edgecollective/mesh-depth/remote/v0.2/hardware/mesh-depth/mesh-depth.pdf

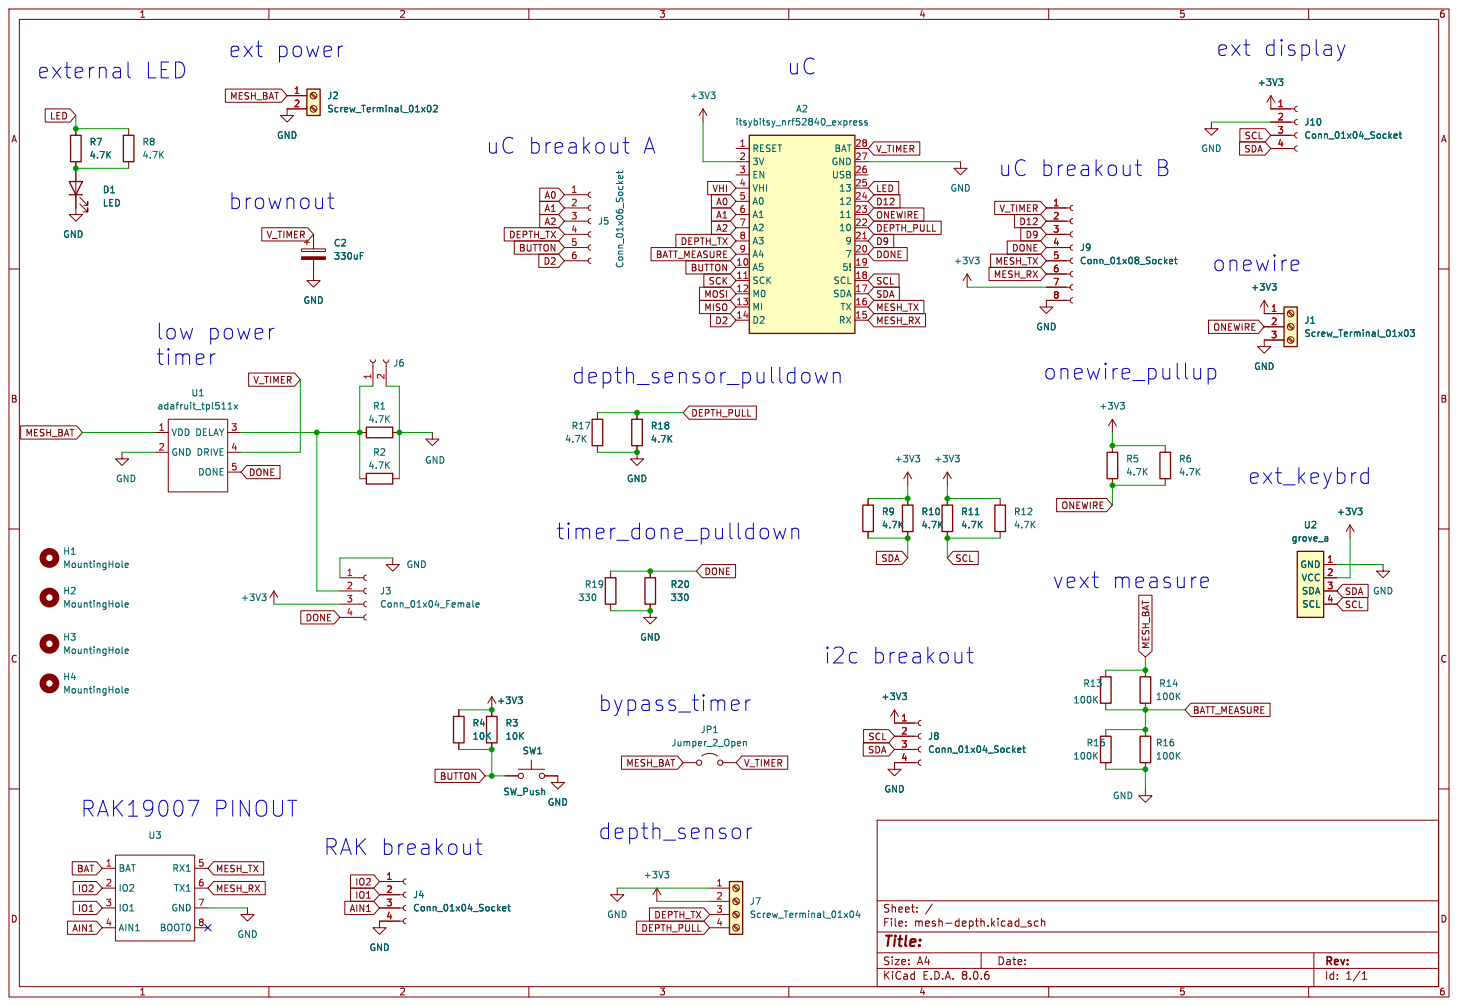
[picture p1: page 1]
