edgecollective/mesh-depth/remote/v0.2/hardware/mesh-depth/mesh-depth.kicad_pcb

## KiCad design remote/v0.2/hardware/mesh-depth/mesh-depth.kicad_pcb (2025-04-04)

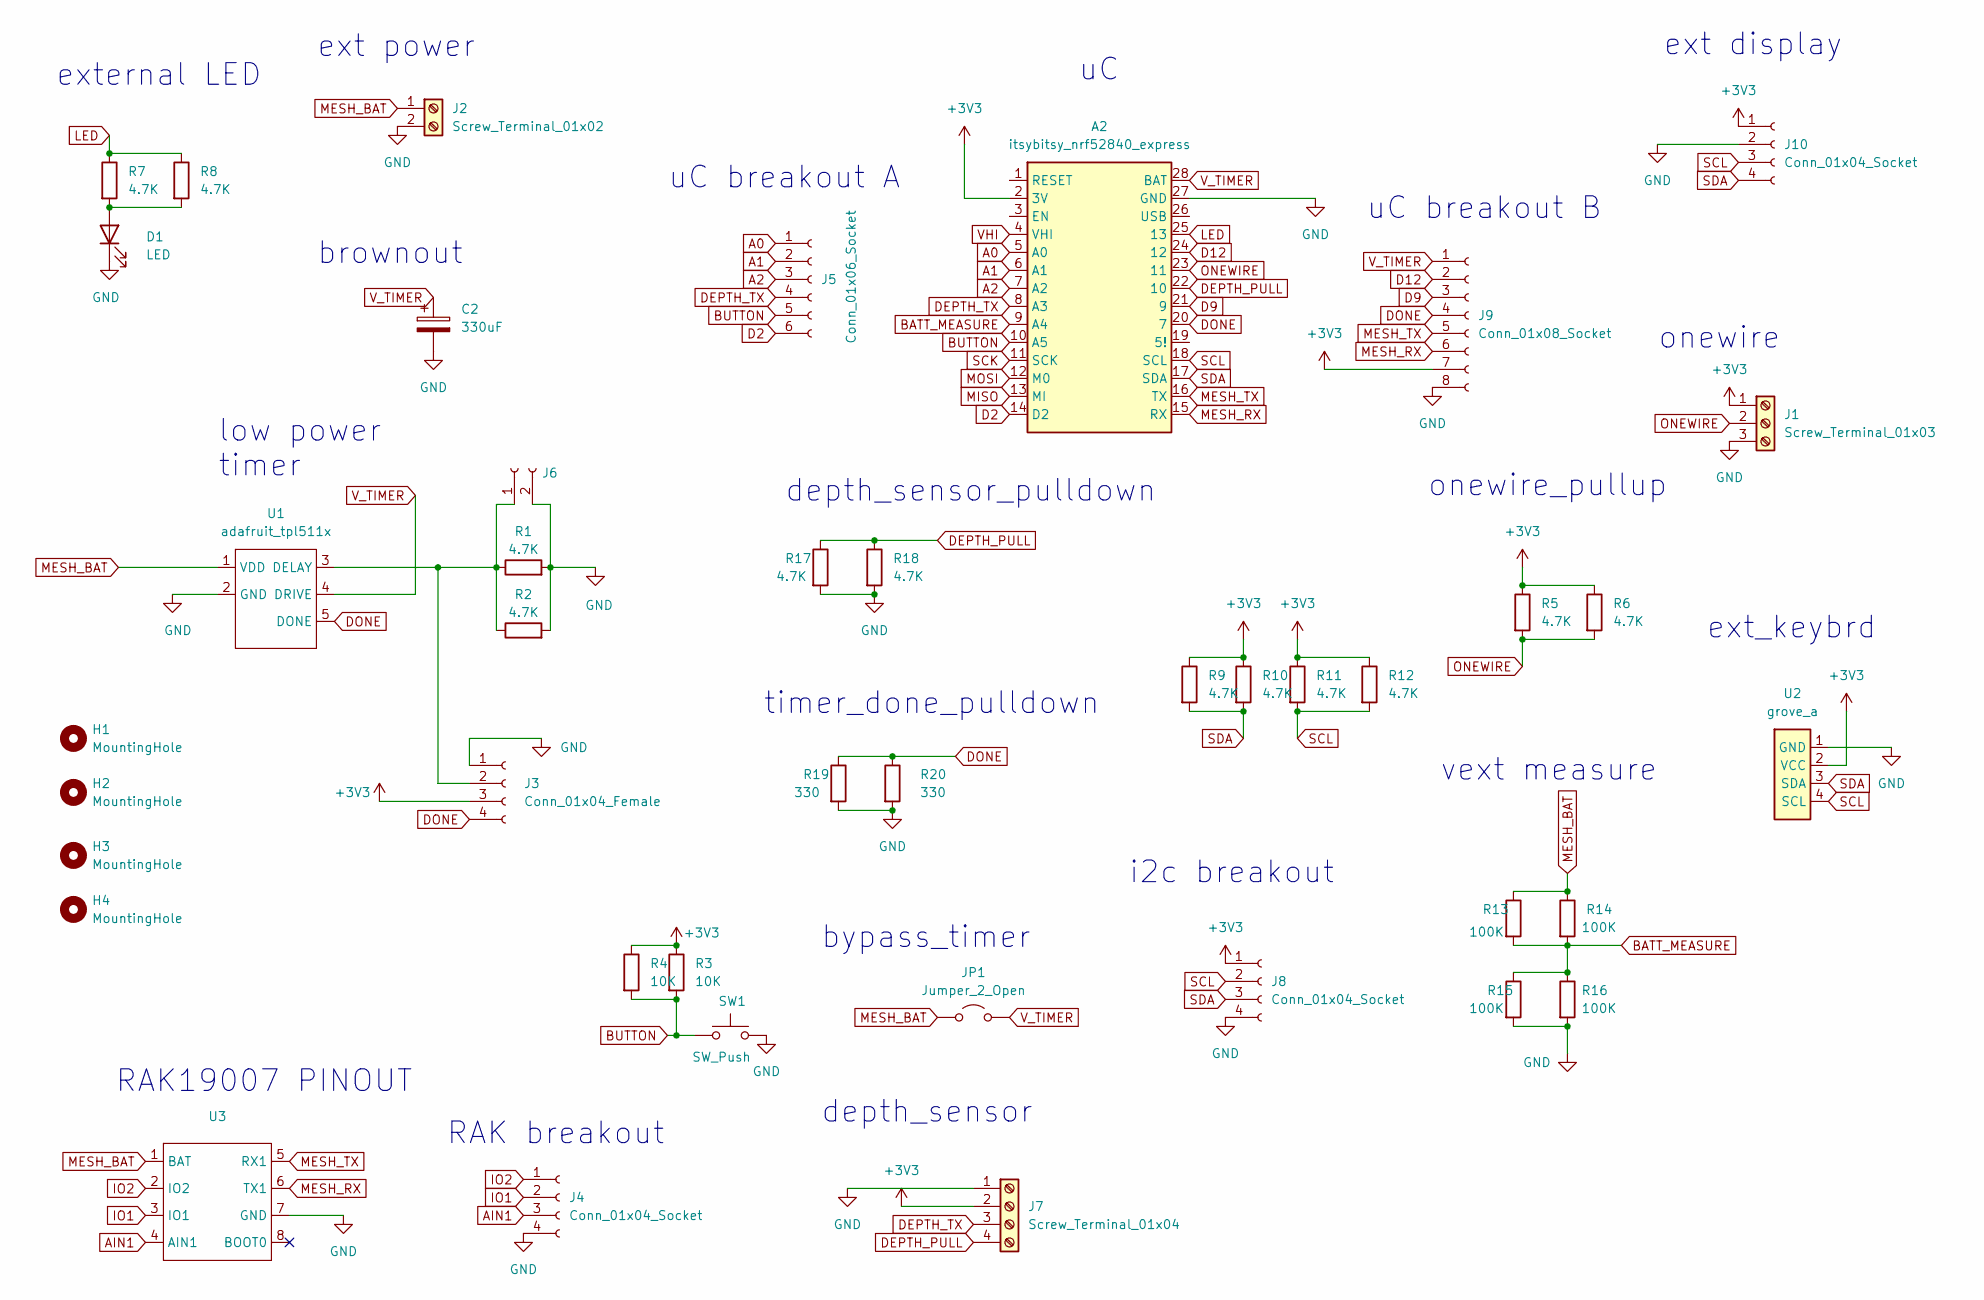
[picture p2: schematic mesh-depth.kicad_sch]

Parts:
A2: itsybitsy_nrf52840_express; itsybitsy
C2: 330uF; CP_Radial_D5.0mm_P2.00mm
D1: LED; LED_D5.0mm
H1, H2, H3, H4: MountingHole; MountingHole_3.2mm_M3
J1: Screw_Terminal_01x03; TerminalBlock_Phoenix_MKDS-1,5-3_1x03_P5.00mm_Horizontal
J2: Screw_Terminal_01x02; TerminalBlock_Phoenix_MKDS-1,5-2_1x02_P5.00mm_Horizontal
J3: Conn_01x04_Female; PinSocket_1x04_P2.54mm_Vertical
J4, J8: Conn_01x04_Socket; PinHeader_1x04_P2.54mm_Vertical
J5: Conn_01x06_Socket; PinHeader_1x06_P2.54mm_Vertical
J6: Conn_01x02_Socket; PinSocket_1x02_P2.54mm_Vertical
J7: Screw_Terminal_01x04; TerminalBlock_Phoenix_MKDS-1,5-4_1x04_P5.00mm_Horizontal
J9: Conn_01x08_Socket; PinHeader_1x08_P2.54mm_Vertical
J10: Conn_01x04_Socket; ssd1306_a
JP1: Jumper_2_Open; SolderJumper-2_P1.3mm_Open_Pad1.0x1.5mm
R1, R5, R8, R10, R11, R18: 4.7K; R_0603_1608Metric_Pad0.98x0.95mm_HandSolder
R2, R6, R7, R9, R12, R17: 4.7K; R_Axial_DIN0204_L3.6mm_D1.6mm_P7.62mm_Horizontal
R3: 10K; R_0603_1608Metric_Pad0.98x0.95mm_HandSolder
R4: 10K; R_Axial_DIN0204_L3.6mm_D1.6mm_P7.62mm_Horizontal
R13, R15: 100K; R_Axial_DIN0204_L3.6mm_D1.6mm_P7.62mm_Horizontal
R14, R16: 100K; R_0603_1608Metric_Pad0.98x0.95mm_HandSolder
R19: 330; R_Axial_DIN0204_L3.6mm_D1.6mm_P7.62mm_Horizontal
R20: 330; R_0603_1608Metric_Pad0.98x0.95mm_HandSolder
SW1: SW_Push; SW_PUSH_6mm
U1: adafruit_tpl511x
U2: grove_a
U3: rak19007

Connections:
+3V3: A2.2 (3V), J1.1, J3.3, J7.2, J8.1, J9.7, J10.1, R3.1, R4.1, R5.1, R6.1, R9.1, R10.1, R11.1, R12.1, U2.2 (VCC)
A0: A2.5 (A0), J5.1
A1: A2.6 (A1), J5.2
A2: A2.7 (A2), J5.3
AIN1: J4.3, U3.4 (AIN1)
BATT_MEASURE: A2.9 (A4), R13.2, R14.2, R15.1, R16.1
BUTTON: A2.10 (A5), J5.5, R3.2, R4.2, SW1.1
D2: A2.14 (D2), J5.6
D9: A2.21 (9), J9.3
D12: A2.24 (12), J9.2
DEPTH_PULL: A2.22 (10), J7.4, R17.1, R18.1
DEPTH_TX: A2.8 (A3), J5.4, J7.3
DONE: A2.20 (7), J3.4, J9.4, R19.1, R20.1, U1.5 (DONE)
GND: A2.27 (GND), C2.2, D1.1 (K), J1.3, J2.2, J3.1, J4.4, J6.2, J7.1, J8.4, J9.8, J10.2, R1.2, R2.2, R15.2, R16.2, R17.2, R18.2, R19.2, R20.2, SW1.2, U1.2 (GND), U2.1 (GND), U3.7 (GND)
IO1: J4.2, U3.3 (IO1)
IO2: J4.1, U3.2 (IO2)
LED: A2.25 (13), R7.1, R8.1
MESH_BAT: J2.1, JP1.1 (A), R13.1, R14.1, U1.1 (VDD), U3.1 (BAT)
MESH_RX: A2.15 (RX), J9.6, U3.6 (TX1)
MESH_TX: A2.16 (TX), J9.5, U3.5 (RX1)
MISO: A2.13 (MI)
MOSI: A2.12 (M0)
unnamed: D1.2 (A), R7.2, R8.2
unnamed: J3.2, J6.1, R1.1, R2.1, U1.3 (DELAY)
ONEWIRE: A2.23 (11), J1.2, R5.2, R6.2
SCK: A2.11 (SCK)
SCL: A2.18 (SCL), J8.2, J10.3, R11.2, R12.2, U2.4 (SCL)
SDA: A2.17 (SDA), J8.3, J10.4, R9.2, R10.2, U2.3 (SDA)
VHI: A2.4 (VHI)
V_TIMER: A2.28 (BAT), C2.1, J9.1, JP1.2 (B), U1.4 (DRIVE)

Notes on the sheet:
uC breakout A
bypass_timer
brownout
depth_sensor_pulldown
vext measure
onewire
timer_done_pulldown
ext_keybrd
onewire_pullup
uC breakout B
external LED
depth_sensor
RAK breakout
low power timer
ext power
i2c breakout
ext display
RAK19007 PINOUT

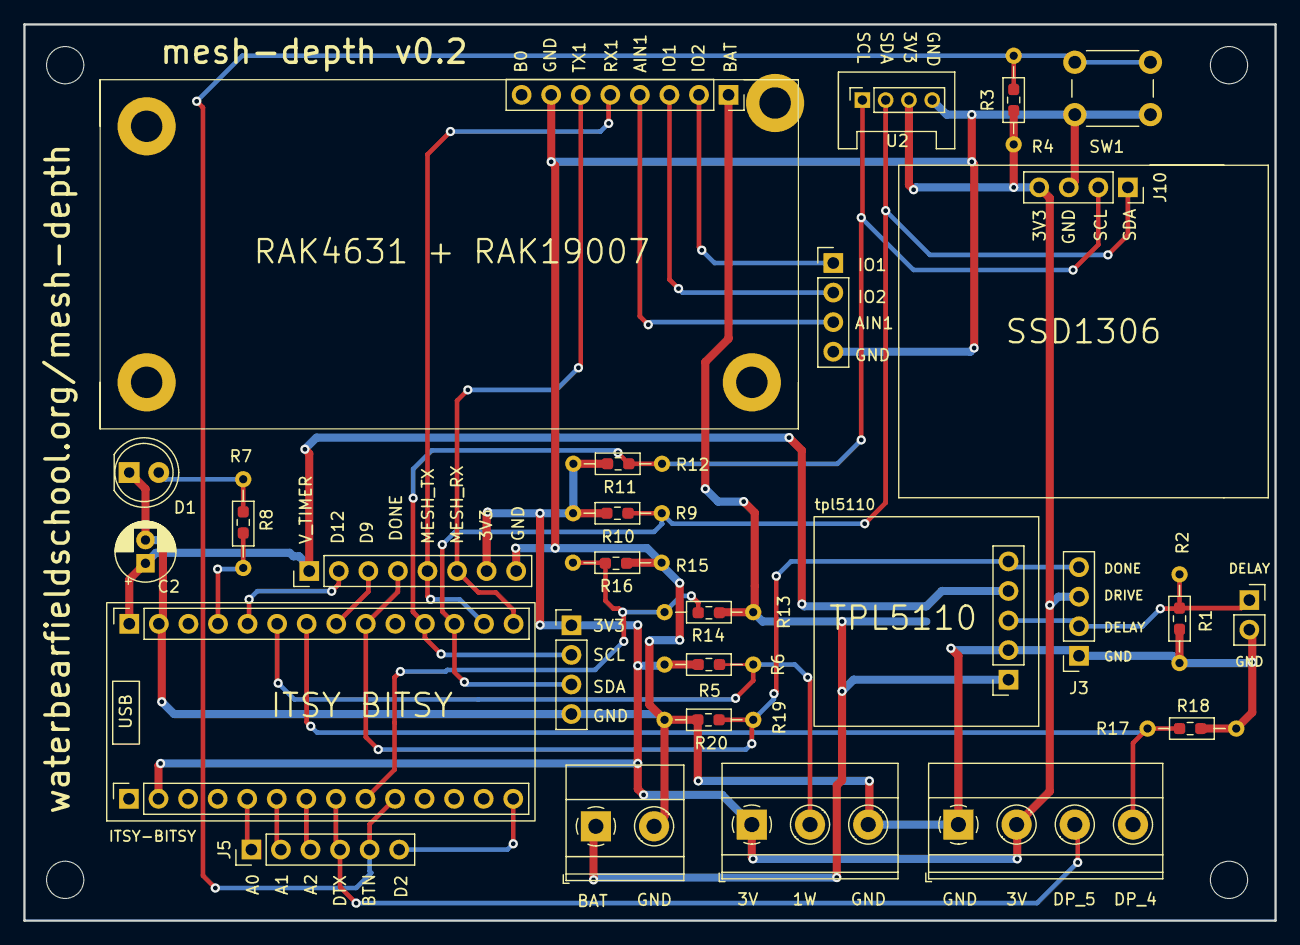
[picture p3: board mesh-depth.kicad_pcb from above]

Board: 2 copper layers, 107.5 x 77.0 mm, 42 parts (1 on the bottom side), 26 nets.
