edgecollective/mesh-depth/base/v0.2/hardware/mesh-base/mesh-base.kicad_pcb

## KiCad design base/v0.2/hardware/mesh-base/mesh-base.kicad_pcb (2025-04-04)

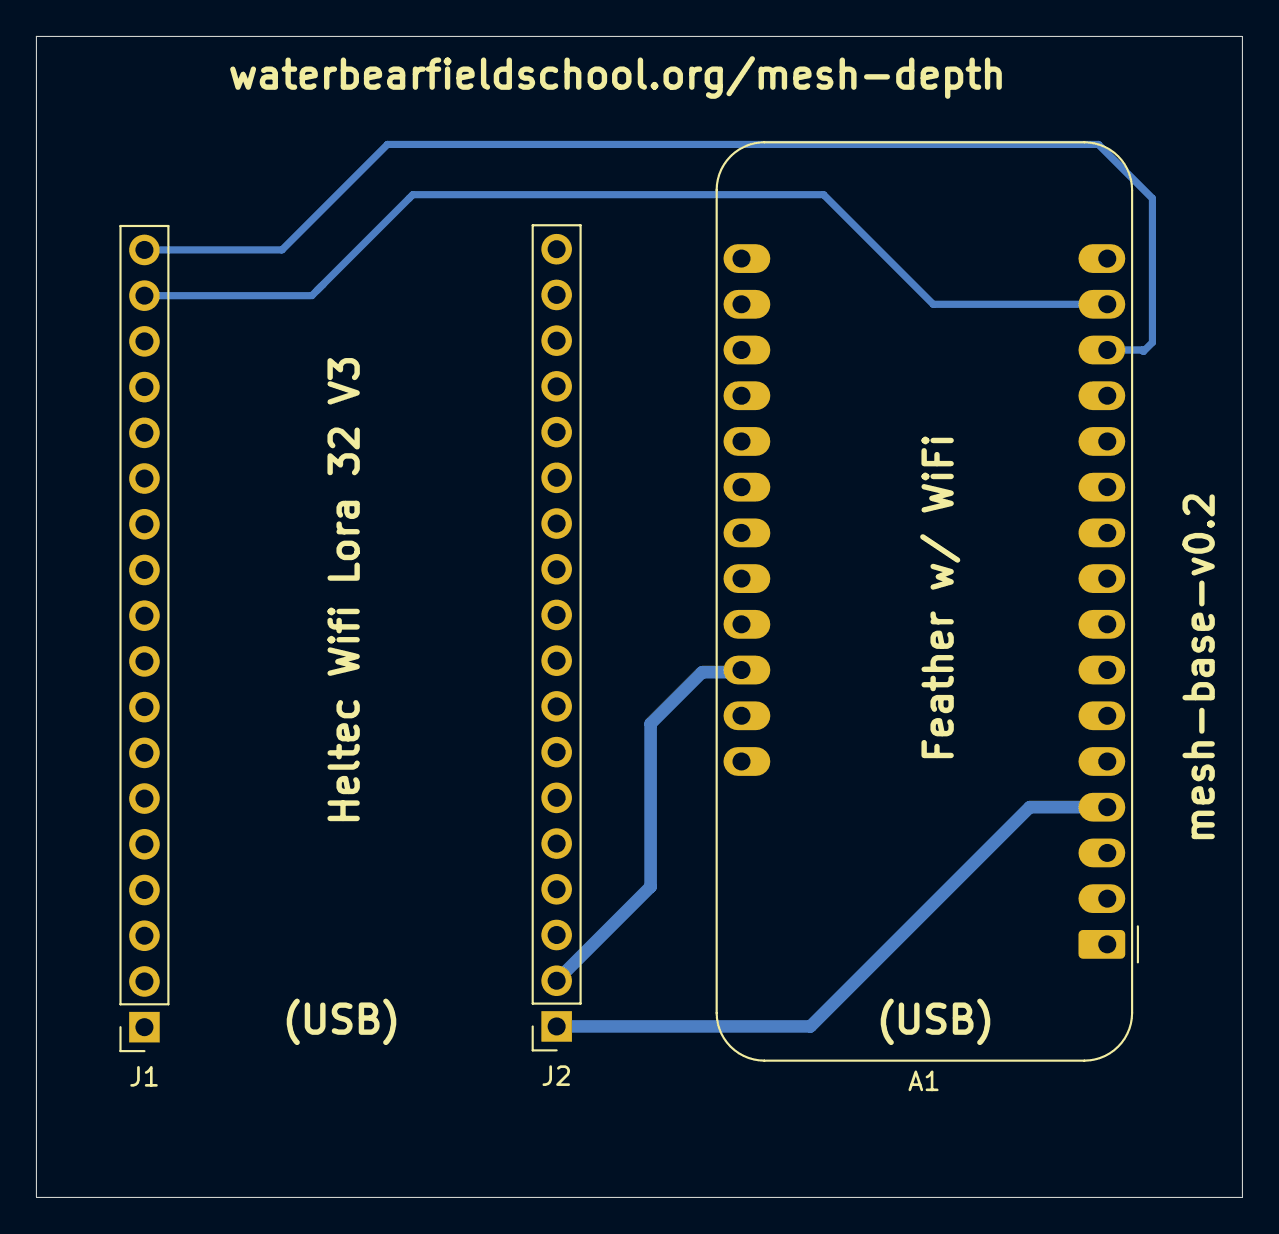
[picture p4: board mesh-base.kicad_pcb from above]

Board: 2 copper layers, 67.0 x 64.5 mm, 3 parts (0 on the bottom side), 4 nets.

Parts:
A1: Adafruit_Feather_Generic; Adafruit_Feather
J1, J2: Conn_01x18_Socket; PinSocket_1x18_P2.54mm_Vertical

Connections:
GND: A1.4 (GND), J2.1
GPIO6: A1.15 (TX), J1.17
GPIO7: A1.14 (RX), J1.18
VUSB: A1.26 (USB), J2.2
